linhuabei/sEMG-wristband-8ch/algorithm/outputs/汇总表.md

| run | 模式 | 任务 | 类别数 | 预处理 | 受试者 | 准确率 | 宏F1 | 仅动作 | 角度R² | 角度r | 角度MAE° | 逐人均值 | 逐人标准差 | 参数量 |
|---|---|---|---|---|---|---|---|---|---|---|---|---|---|---|
| ab6_none | pooled | 离散手势 | 18 | ?+? | 0 人 | 0.6771 | 0.4801 | 0.4045 |  |  |  | 0.6761 | 0.0705 | 80466 |
| ex1_persubject_angles | per-subject | 连续角度 | 18 | online+rolling | 4 人 | 0.0388 | 0.0435 | 0.061 | 0.4706 | 0.68 | 7.645 | 0.0388 | 0.0058 | 81831 |
| ex1_persubject_app6 | per-subject | 离散手势 | 7 | online+rolling | 8 人 | 0.7166 | 0.5541 | 0.6671 |  |  |  | 0.7084 | 0.0949 |  |
| ex1_persubject_gesture | per-subject | 离散手势 | 18 | online+rolling | 8 人 | 0.6735 | 0.495 | 0.447 |  |  |  | 0.6733 | 0.0767 |  |
| ex1_persubject_multitask | per-subject | 分类+角度 | 18 | online+rolling | 3 人 | 0.5728 | 0.4799 | 0.5778 | 0.3317 |  |  | 0.5731 | 0.0647 |  |
| pilot_angles_s1 | per-subject | 连续角度 | 18 | online+rolling | 1 人 | 0.0299 | 0.0287 | 0.0642 | 0.4871 | 0.6899 | 7.16 | 0.0299 | 0.0 | 81831 |
| pilot_angles_win400_s1 | per-subject | 连续角度 | 18 | online+rolling | 1 人 | 0.0699 | 0.0333 | 0.0585 | 0.4756 | 0.6736 | 7.31 | 0.0699 | 0.0 | 81831 |
| pilot_bal_s1_2 | pooled | 离散手势 | 18 | ?+? | 0 人 | 0.613 | 0.4483 | 0.4778 |  |  |  | 0.6133 | 0.0282 | 80466 |
| pilot_s1_2 | pooled | 离散手势 | 18 | ?+? | 0 人 | 0.677 | 0.3781 | 0.3212 |  |  |  | 0.6773 | 0.0254 | 80466 |
| test_persubj | per-subject | 离散手势 | 18 | ?+? | 2 人 | 0.7705 | 0.5932 | 0.5487 |  |  |  | 0.7706 | 0.0053 |  |
