linhuabei/sEMG-wristband-8ch/algorithm/outputs/模型结构图_7类手势.png

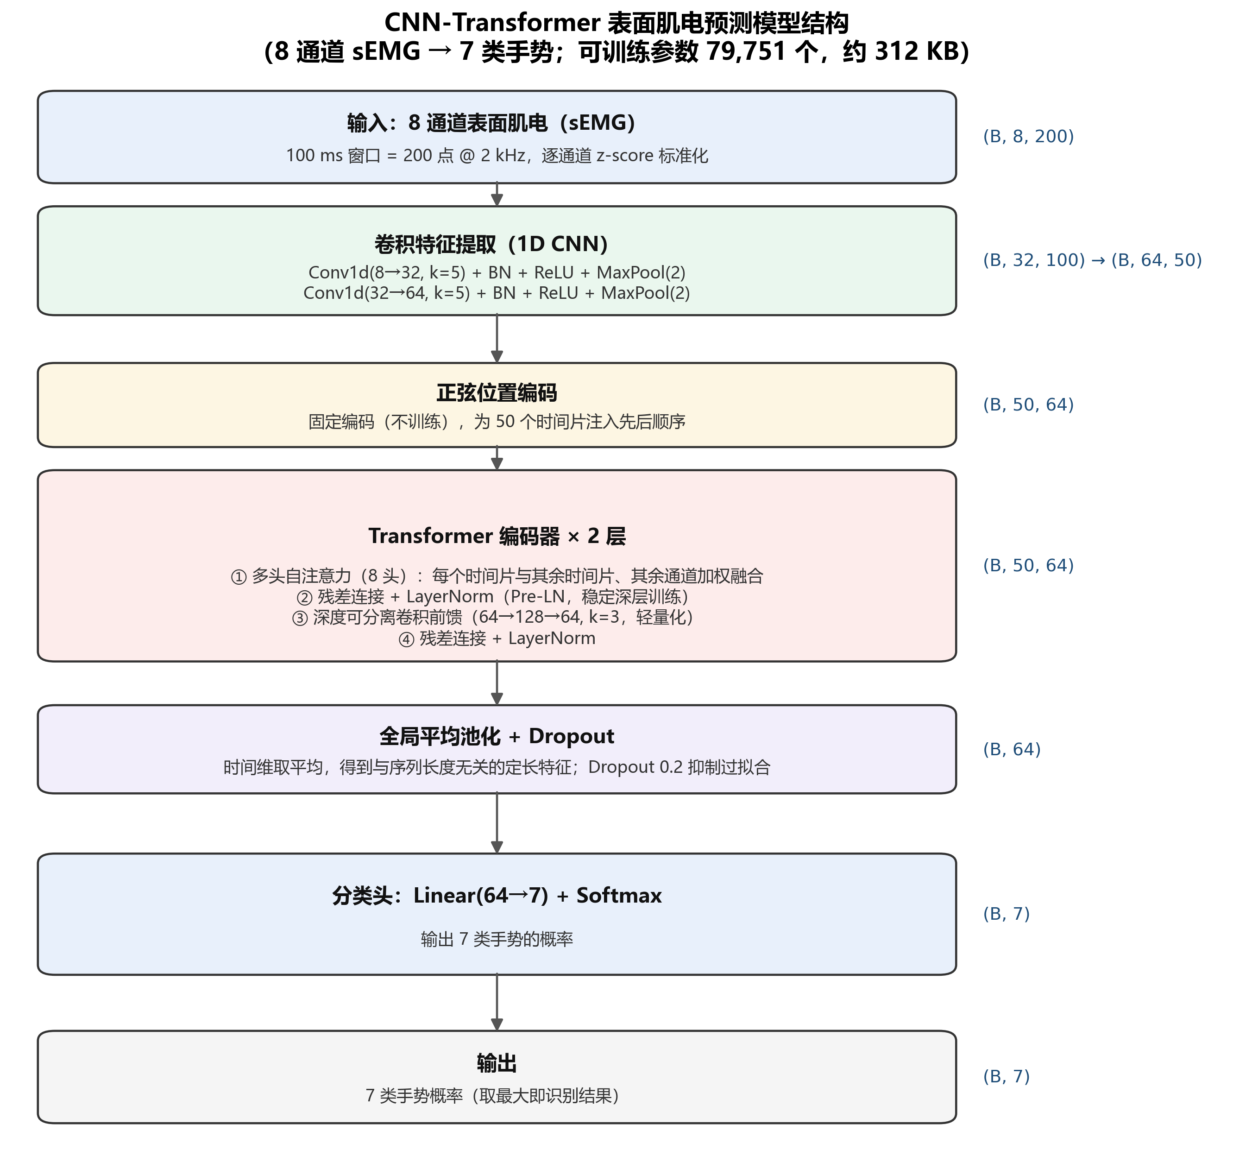
algorithm/outputs/模型结构图_7类手势.png
