linhuabei/sEMG-wristband-8ch/algorithm/outputs/模型结构图_多任务.png

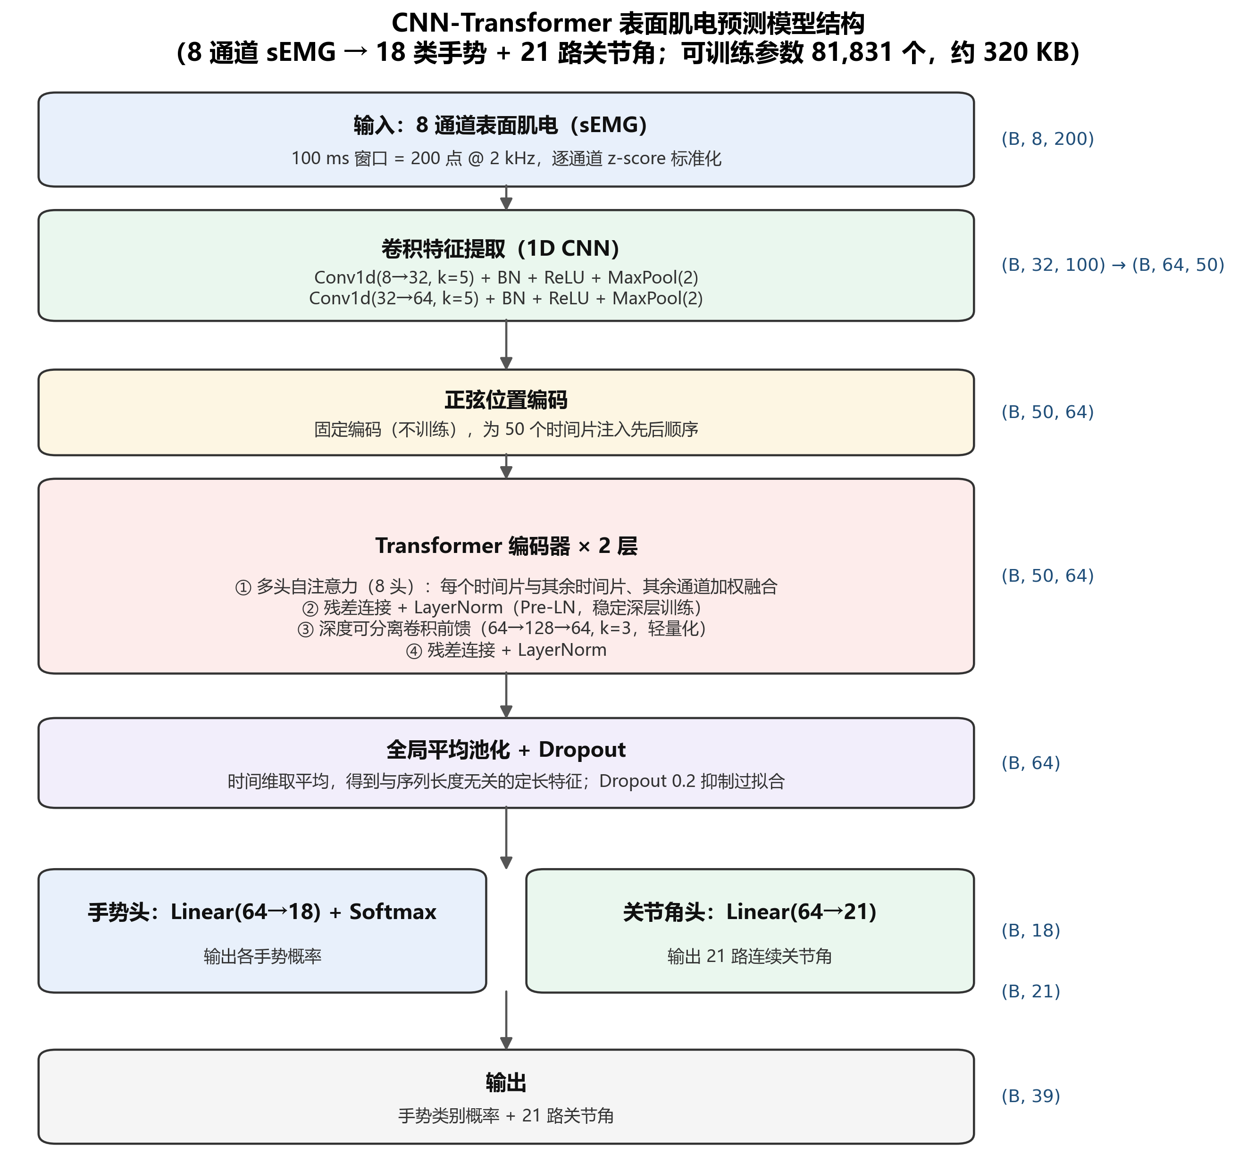
algorithm/outputs/模型结构图_多任务.png
