linhuabei/sEMG-wristband-8ch/hardware/BOM.xlsx

No. | Quantity | Comment | Designator | Footprint | Value | Manufacturer Part | Manufacturer | Supplier Part | Supplier
1 | 1 | 100nF | C1 | C0402 | 100nF | HGC0402R5106M100NTEJ | Chinocera(华瓷) |  | LCSC
2 | 1 | 4.7uF | C2 | C0402 | 4.7uF | HGC0402R5106M100NTEJ | Chinocera(华瓷) |  | LCSC
3 | 3 | 100nF | C4,C10,C12 | C0402 | 100nF | CL05B104KO5NNNC | SAMSUNG(三星) | C1525 | LCSC
4 | 1 | 1uF | C8 | C0402 | 1uF | CGA0603X5R105K160JT | HRE(芯声) | C6119849 | LCSC
5 | 1 | 10uF | C9 | C0402 | 10uF | CGA0805X5R106K250MT | HRE(芯声) | C6119887 | LCSC
6 | 1 | 4.7uF | C25 | C0402 | 4.7uF | CL10A475KO8NNNC | SAMSUNG(三星) | C19666 | LCSC
7 | 16 | 68pF | C37,C38,C39,C40,C41,C42,C43,C44,C45,C46,C47,C48,C49,C50,C51,C52 | C0402 | 68pF
8 | 1 | 10uF | C53 | C0402 | 10uF
9 | 2 | 0.1uF | C54,C61 | C0402 | 0.1uF
10 | 3 | 1uF | C55,C57,C60 | C0402 | 1uF
11 | 1 | 22uF | C56 | C0402 | 22uF
12 | 1 | 1nF | C58 | C0402 | 1nF
13 | 1 | 1.5nF | C59 | C0402 | 1.5nF
14 | 4 | 1uF | C62,C63,C64,C65 | C0603 | 1uF
15 | 2 | 68711014522 | FPC1,FPC2 | FPC-10P-P0.50_68711014022 |  | 68711014522 | Wurth(伍尔特) | C6700243 | LCSC
16 | 2 | MSLED0402 | LED1,LED4 | LED0402-RD_GREEN |  | MSLED0402 |  | C9900013127 | LCSC
17 | 1 | 充电中 | LED2 | LED0402-RD_GREEN |  | 充电中 | XINGLIGHT(成兴光) | C965793 | LCSC
18 | 1 | XL-1005UGC | LED3 | LED0402-RD_GREEN |  | XL-1005UGC | XINGLIGHT(成兴光) | C965793 | LCSC
19 | 3 | 220 | R1,R3,R6 | R0402 | 220 | FRC0402F1002TS | FOJAN(富捷) |  | LCSC
20 | 1 | 3.3k | R2 | R0402 | 3.3k | RT0402BRD071KL | YAGEO(国巨) |  | LCSC
21 | 4 | 10kΩ | R4,R5,R7,R57 | R0402 | 10kΩ | FRC0402F1002TS | FOJAN(富捷) | C2906861 | LCSC
22 | 1 | 1kΩ | R8 | R0402 | 1kΩ | FRC0402F1002TS | FOJAN(富捷) |  | LCSC
23 | 1 | 1.78kΩ | R55 | R0402 | 1.78kΩ | PTFR0402B1K78P9 | RESI(开步睿思) | C2693028 | LCSC
24 | 2 | 1kΩ | R58,R59 | R0402 | 1kΩ | 0402WGF1001TCE | UNI-ROYAL(厚声) | C11702 | LCSC
25 | 16 | 2kΩ | R67,R68,R69,R70,R71,R72,R73,R74,R75,R76,R77,R78,R79,R80,R81,R82 | R0402 | 2kΩ | RT0402BRD072KL | YAGEO(国巨) | C852711 | LCSC
26 | 1 | 1M | R83 | R0402 | 1M
27 | 1 | MINI MSK12CO2 | SW4 | SW-SMD_MSK12CO2 |  | MINI MSK12CO2 | SHOU HAN(首韩) | C2681570 | LCSC
28 | 1 | ZX-ZH1.5-2PLT | U2 | CONN-SMD_2P-P1.50_ZX-ZH1.5-2PLT |  | ZX-ZH1.5-2PLT | Megastar(兆星) | C19272414 | LCSC
29 | 1 | HC-FPC-0.5-4P-CSH20 | U4 | FPC-SMD_4P-P0.50_HC-FPC-0.5-4P-CSH20 |  | HC-FPC-0.5-4P-CSH20 | HC(虹成电子) | C19273944 | LCSC
30 | 1 | LSM6DSRTR | U6 | LGA-14_L3.0-W2.5-P0.50-BR |  | LSM6DSRTR | ST(意法半导体) | C784817 | LCSC
31 | 1 | BQ24075RGTR | U8 | QFN-16_L3.0-W3.0-P0.50-TL-EP1.7 |  | BQ24075RGTR | TI(德州仪器) | C15464 | LCSC
32 | 1 | ADS1298IPAGR | U11 | TQFP-64_L10.0-W10.0-P0.50-LS12.0-BL |  | ADS1298IPAGR | TI(德州仪器) | C527440 | LCSC
33 | 1 | BX-ZH1.5-2PWT | U13 | CONN-SMD_2P-P1.50_BX-ZH1.5-2PWT |  | BX-ZH1.5-2PWT | Bossie(博锡) | C19272502 | LCSC
34 | 1 | ESP32-S3-ZERO-最小开发板 | U15 | ESP32-S3-ZERO-邮票封装
35 | 1 | PR5W4036-2P-C-F | U16 | CONN-TH_PR5W4036-2P-C-F |  | PR5W4036-2P-C-F | SAMZO(三佐) | C41361294 | LCSC
36 | 2 | TPS7A2033PDBVR | U17,U18 | SOT-23-5_L2.9-W1.6-P0.95-LS2.8-BR |  | TPS7A2033PDBVR | TI(德州仪器) | C2862740 | LCSC
