linhuabei/sEMG-wristband-8ch/hardware/肌电手环主板3D模型26.9.step

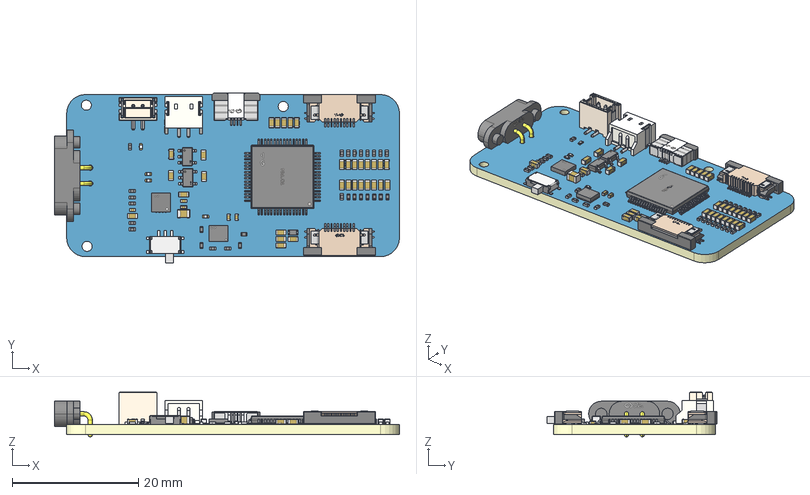
[picture p3: CAD file, 2026-11-07]
hardware/肌电手环主板3D模型26.9.step
54.6 x 27.0 x 7.10 mm
Board~ayLe
TopCopper~ayLe
BottomCopper~ayLe
TopSilkscreen~ayLe
BottomSilkscreen~ayLe
TopFpcStiffener~ayLe
BottomFpcStiffener~ayLe
SW-SMD_MSK12CO2~SW-SMD_MSK12CO2~uWXB
R0402~R0603~Sqxj
C0402~C0805_L2.0-W1.3-H1.3~RqoV
C0402~C0402_L1.0-W0.5-H0.5~MZl7 x 5
CONN-SMD_2P-P1.50_BX-ZH1.5-2PWT~CONN-SMD_2P-P1.50_BX-ZH1.5-2PWT~rTed
LED0402-RD_GREEN~LED0402_L1.0-W0.5-H0.2~waCC x 4
R0402~R0402_L1.0-W0.5-H0.4~kJaa x 28
CONN-SMD_2P-P1.50_ZX-ZH1.5-2PLT~CONN-SMD_2P-P1.50_ZX-ZH1.5-2PLT~fwjj
SOT-23-5_L2.9-W1.6-P0.95-LS2.8-BR~SOT-23-5_L2.9-W1.6-P0.95-LS2.8-BR~X5jP x 2
C0402~C0603_L1.6-W0.8-H0.8~WYN3 x 31
LGA-14_L3.0-W2.5-P0.50-BR~LGA-14_L3.0-W2.5-P0.50-BR~KkzF
CONN-TH_PR5W4036-2P-C-F~CONN-TH_PR5W4036-2P-C-F~GWEt
QFN-16_L3.0-W3.0-P0.50-TL-EP1.7~QFN-16_L3.0-W3.0-P0.50-EP1.7~XNnZ
FPC-SMD_4P-P0.50_HC-FPC-0.5-4P-CSH20~FPC-SMD_4P-P0.50_HC-FPC-0.5-4P-CSH20~5jnB
FPC-10P-P0.50_68711014022~FPC-10P-P0.50_68711014022~ZmO9 x 2
TQFP-64_L10.0-W10.0-P0.50-LS12.0-BL~TQFP-64_L10.0-W10.0-H1.2-LS12.0-P0.50~6vXW
