linhuabei/sEMG-wristband-8ch/hardware/Schematic.pdf

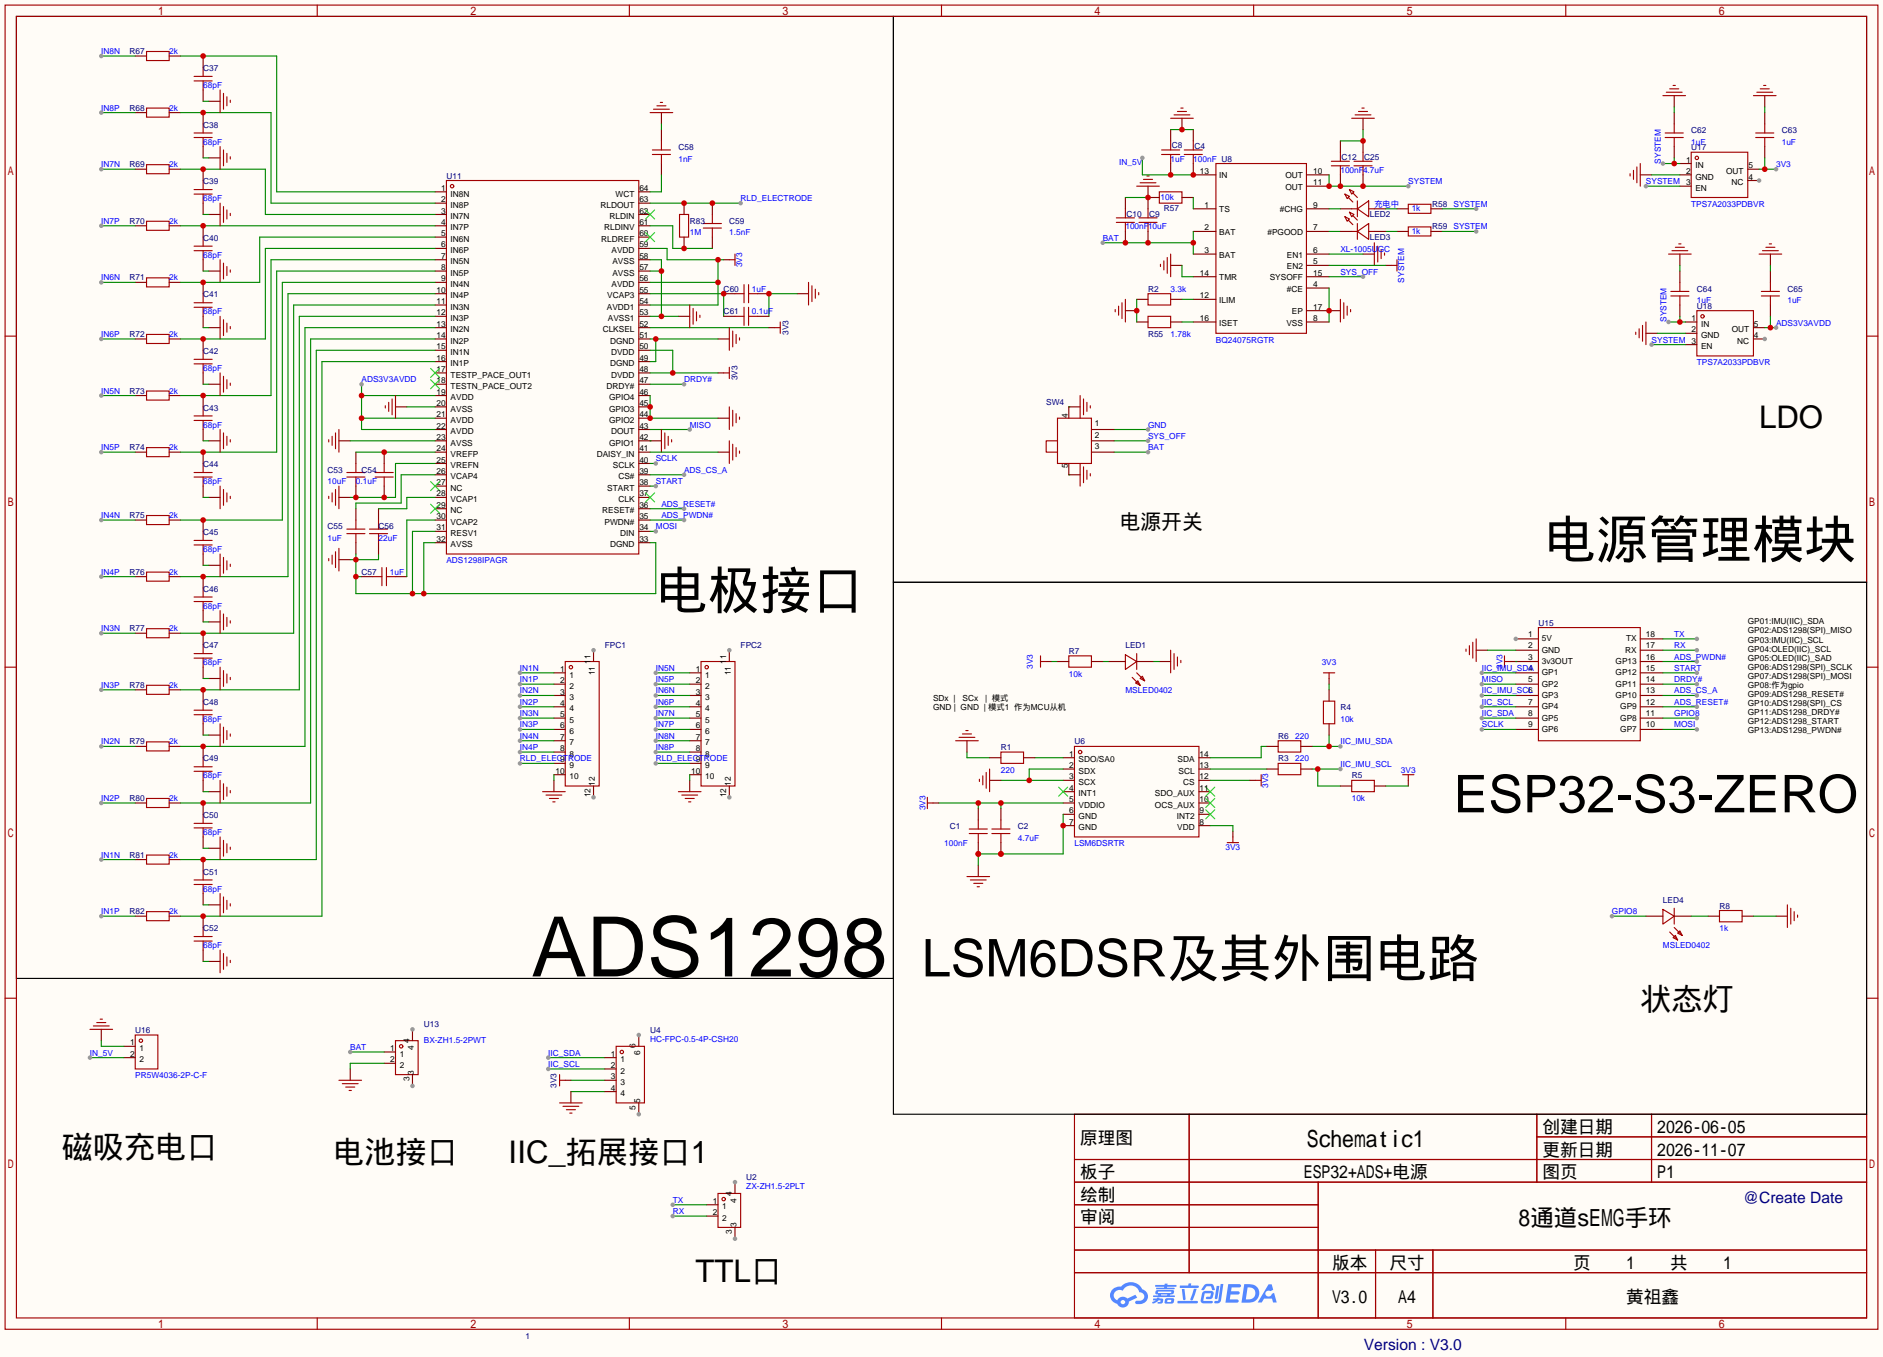
[picture p4: page 1]

原理图 | Schematic1 | 创建日期 | 2026-06-05

更新日期 | 2026-11-07

板子 | ESP32+ADS+电源 | 图页 | P1
绘制 | | @Create Date 8通道sEMG手环
审阅

V3.0 | A4 | 黄祖鑫
