linhuabei/sEMG-wristband-8ch/algorithm/outputs/模型结构图_7类手势.pdf

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

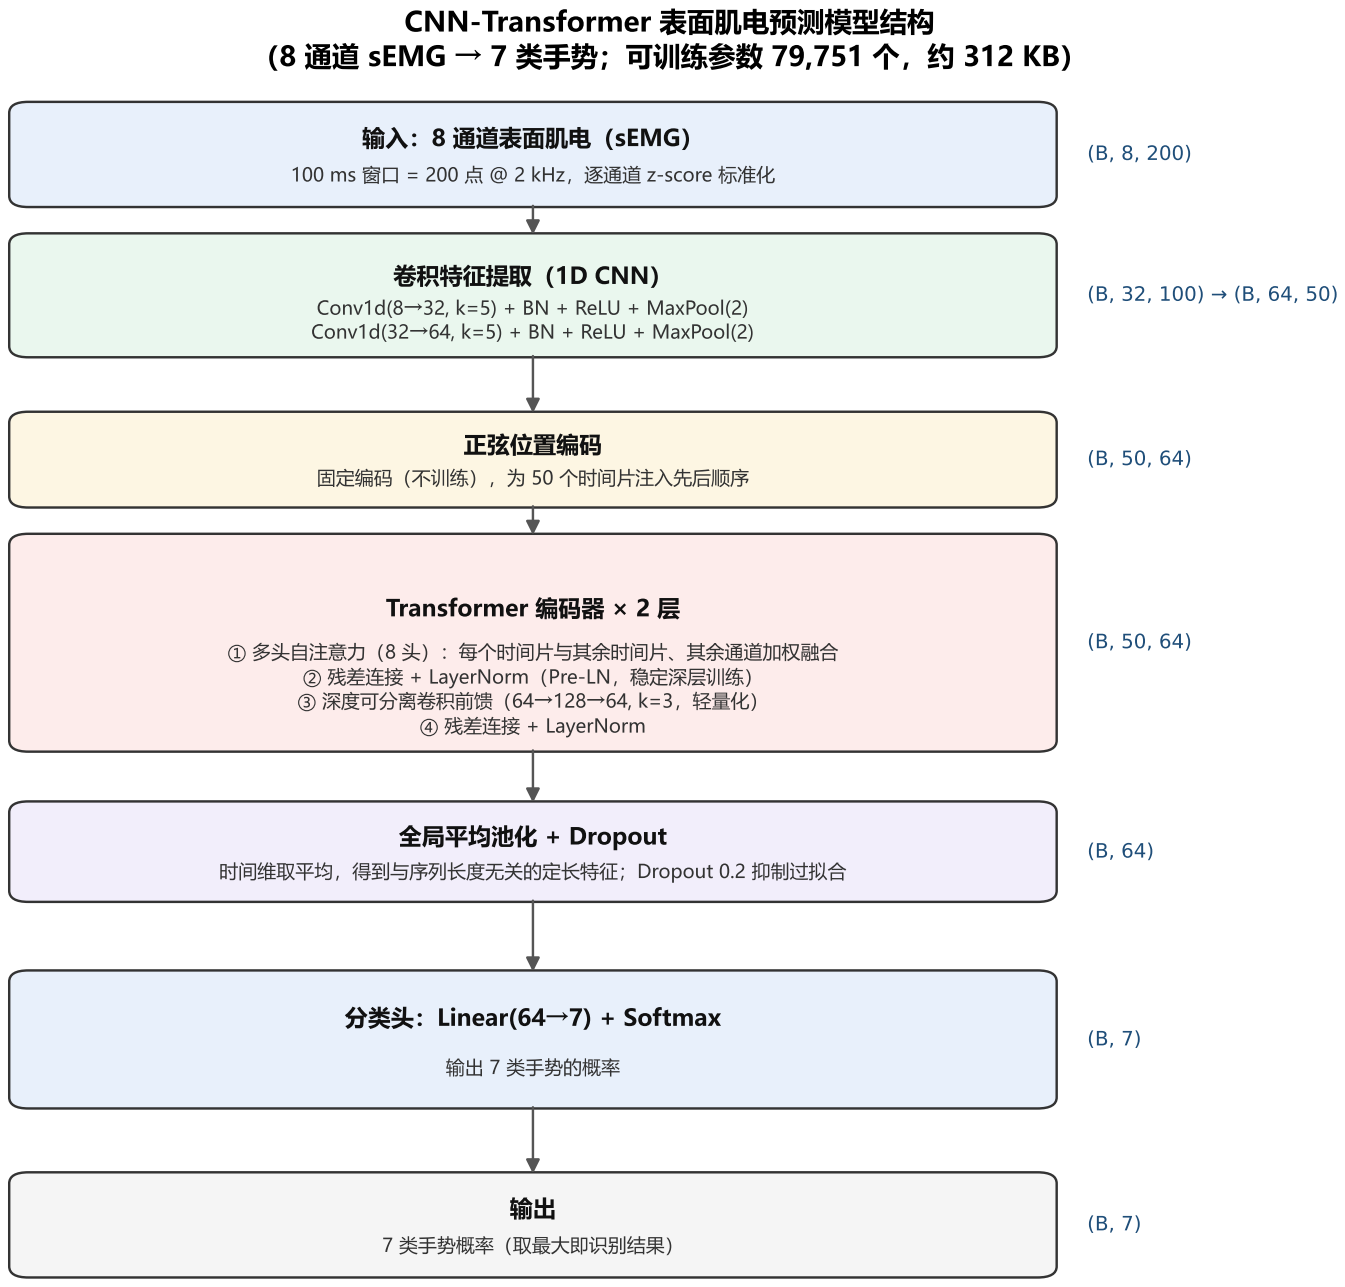
[picture p5: page 1]
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
