linhuabei/sEMG-wristband-8ch/algorithm/outputs/模型结构图_多任务.pdf

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

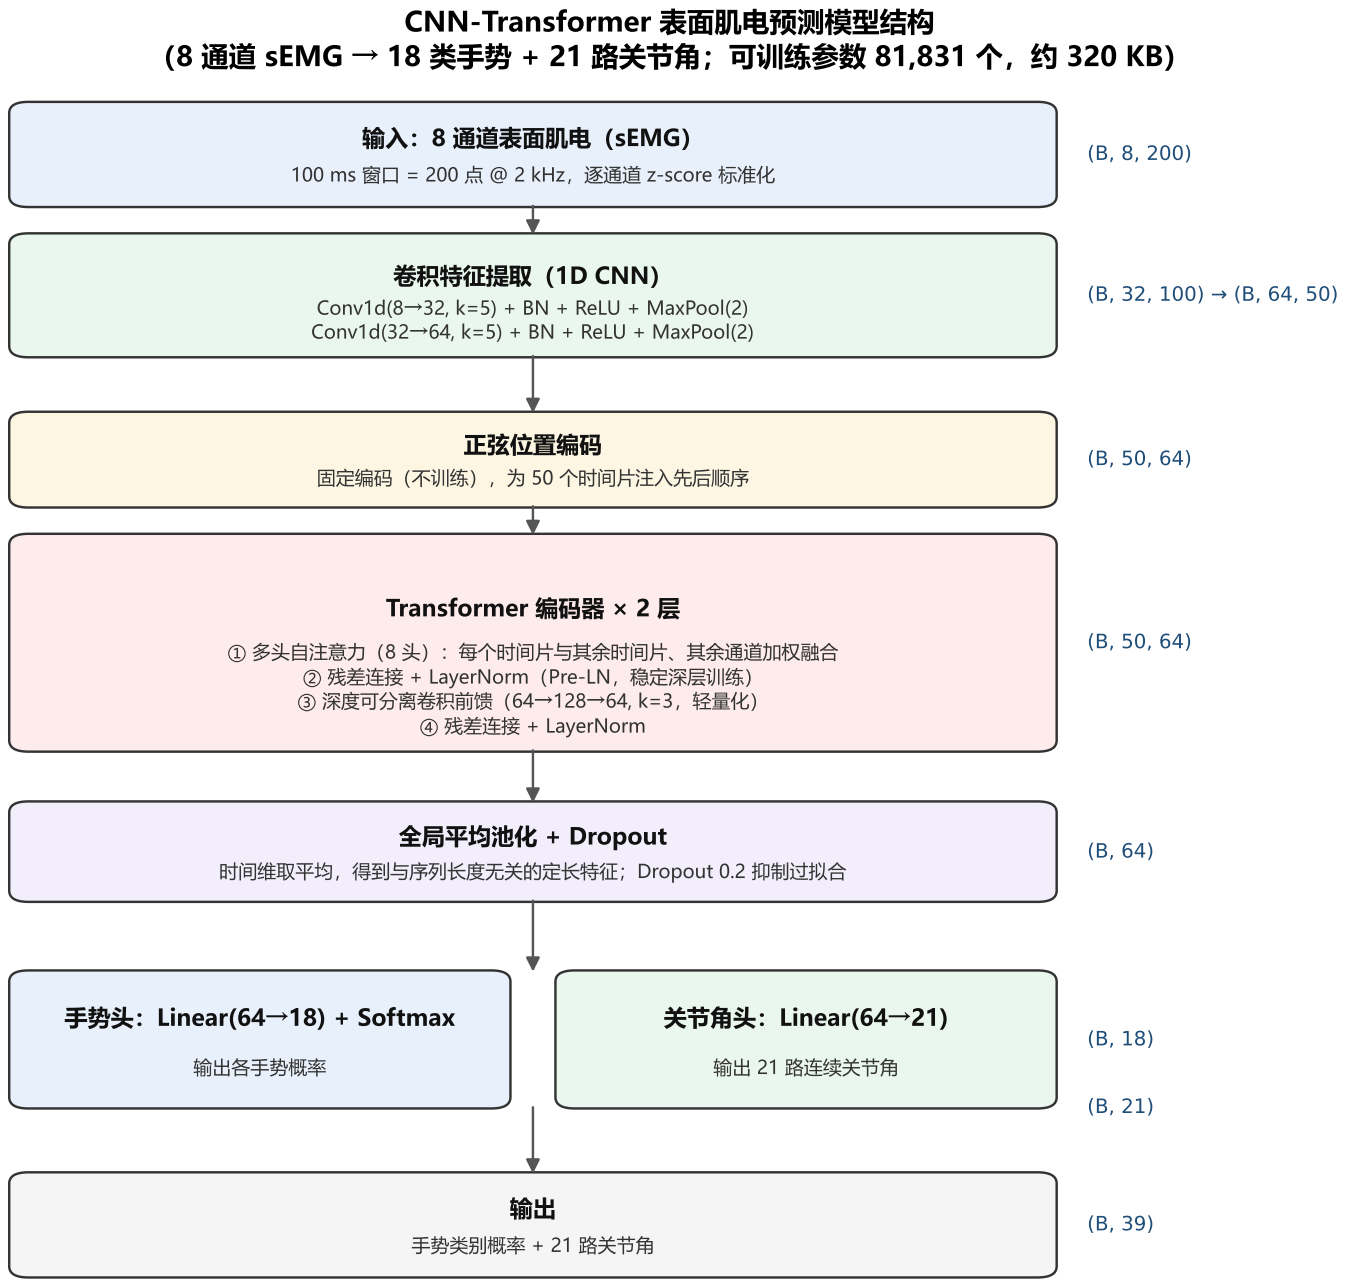
[picture p6: page 1]
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
