linhuabei/sEMG-wristband-8ch/firmware/Node_8CH_ADS1298/src/app/app.h

#pragma once

#include <Arduino.h>

namespace app {

void begin();
void loop();

bool isStreaming();
void startStream();
void stopStream();

void onBleCommand(const String &command);
void onBleConnection(bool connected);

}  // namespace app
