linhuabei/sEMG-wristband-8ch/(commit log)

2026-11-07 Add files via upload
    add hardware bom and pdf
    [BOM.xlsx]
2026-11-07 更新readme
2026-11-07 Refine project description in README.md
    Removed the word '完整的' from the project description for conciseness.
2026-11-07 Add algorithm subproject: 8-channel sEMG CNN-Transformer
    [模型逐层表.csv]
2026-11-07 算法部分
2026-11-07 更新固件
2026-11-11 Clean up comments in 手势识别_CNNTransformer.py
    Removed usage instructions and dependencies from the code.
